LiseR18/KnockDoor/README.md

# Knocki
Knocki is a proof of concept that allows you to open a door by "knocking" a secret combination that you configured beforehand. 
**[Demo video](https://www.youtube.com/watch?v=I42KXvuVLV4)**

*Realised in the context of the Arduino project at Polytech Nice-Sophia*
