LiseR18/KnockDoor/Diapo Knocki.pdf

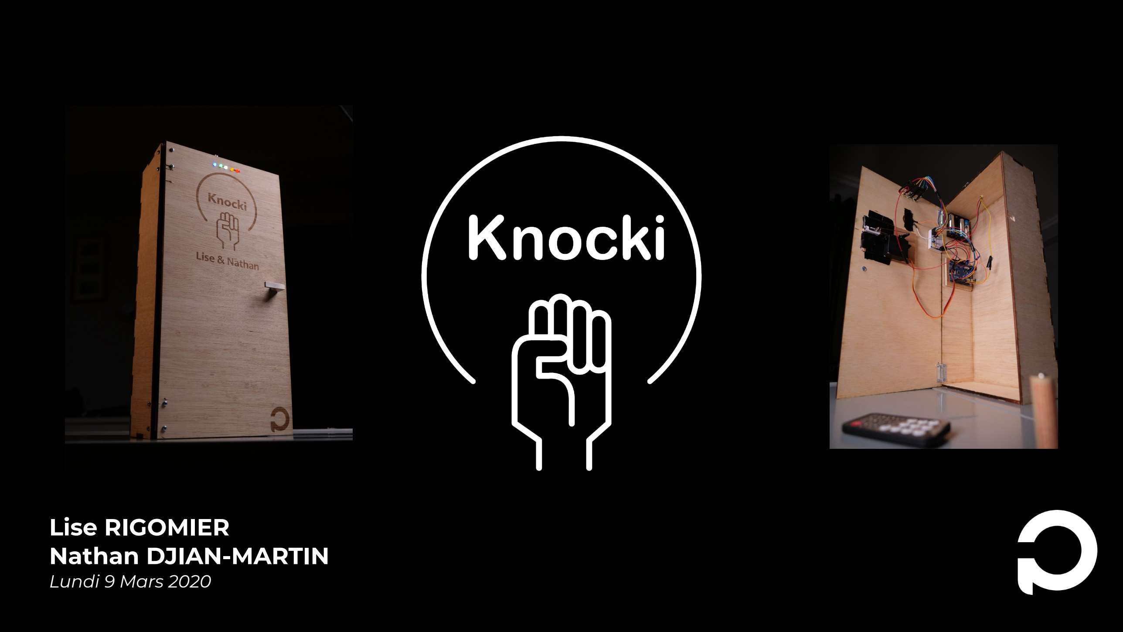
[picture p41: page 1]

Lise RIGOMIER
Nathan DJIAN-MARTIN
Lundi 9 Mars 2020

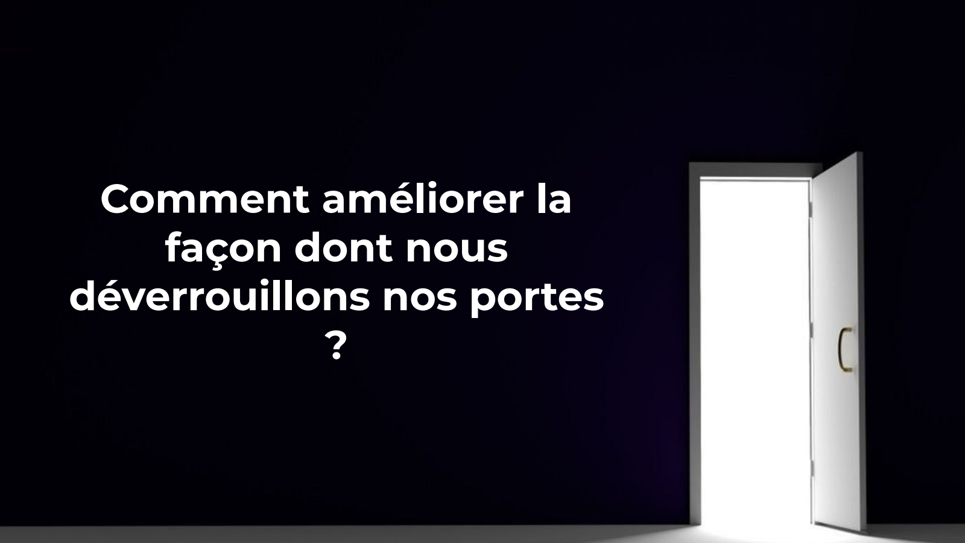
[picture p42: page 2]

Comment améliorer la
façon dont nous
déverrouillons nos portes
?

### SOMMAIRE

1 - Objectifs
2 - Présentation composants et code 3 - Démonstration
4 - Déroulement du projet
5 - Conclusion

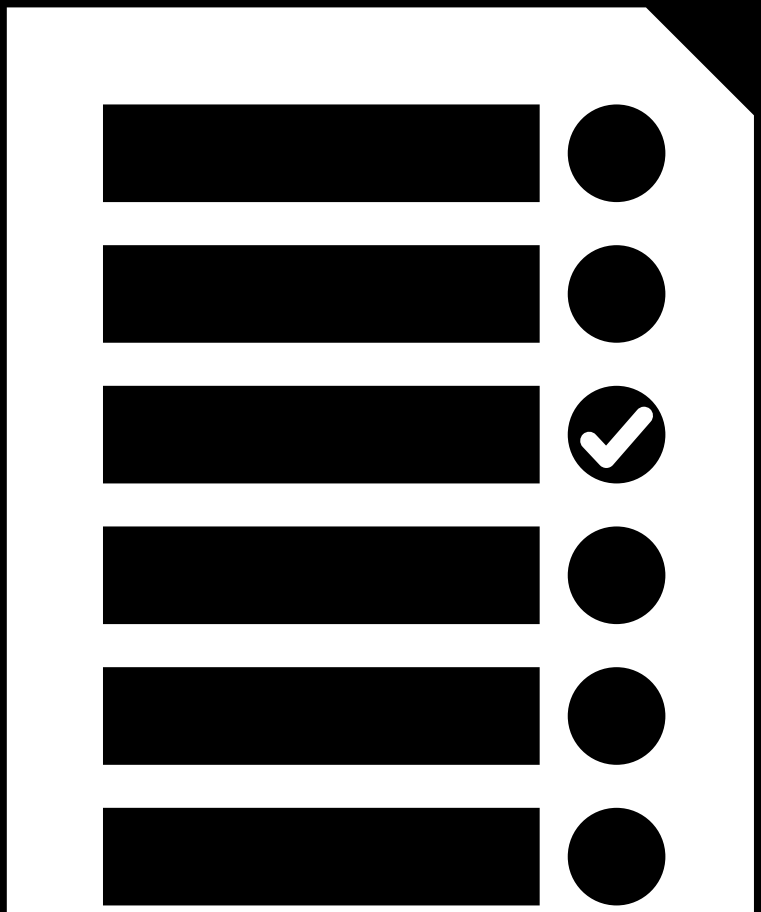
[picture p43: figure]

Détecter une combinaison
Comparer deux combinaisons Ouvrir/fermer la porte
Télécommande infrarouge
Communiquer avec l’utilisateur

### OBJECTIFS

DÉTECTER UNE COMBINAISON

Combinaison

+ écouterCombinaison

+ sauverCombinaison

+ récupCombinaison

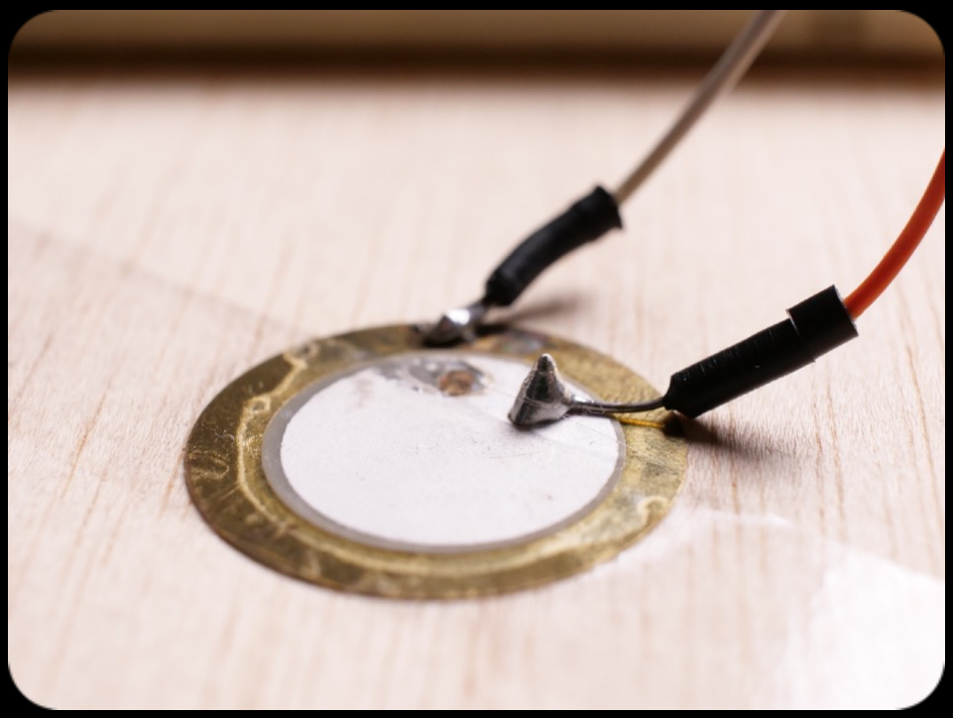
[picture p44: figure]

Coup 1 | Coup 2 Coup 3 | Coup 4

COMPARER DEUX COMBINAISONS

Combinaison

+ écouterCombinaison

+ sauverCombinaison

+ récupCombinaison

+ comparer

Combinaison de référence

Combinaison de l’utilisateur

OUVRIR/FERMER LA PORTE

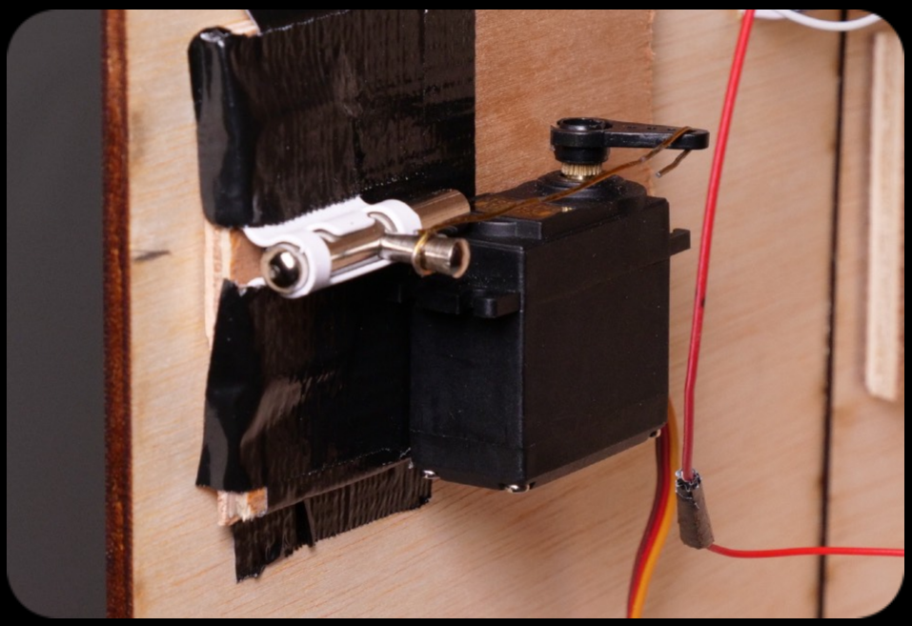
[picture p45: figure]

Servomoteur

+ ouvrirPorte

+ fermerPorte

Trombonne

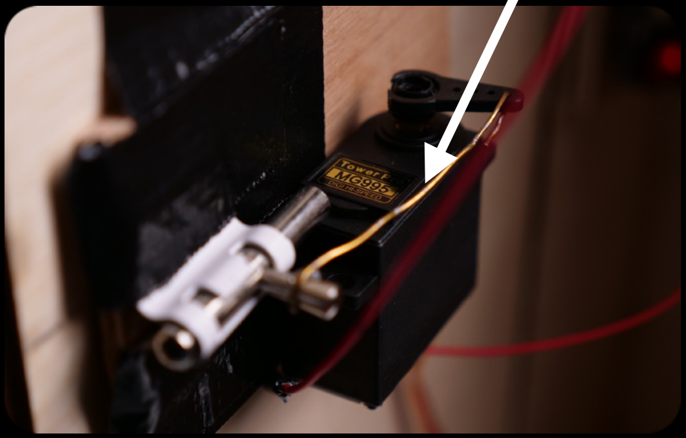
[picture p46: figure]

TÉLÉCOMMANDE

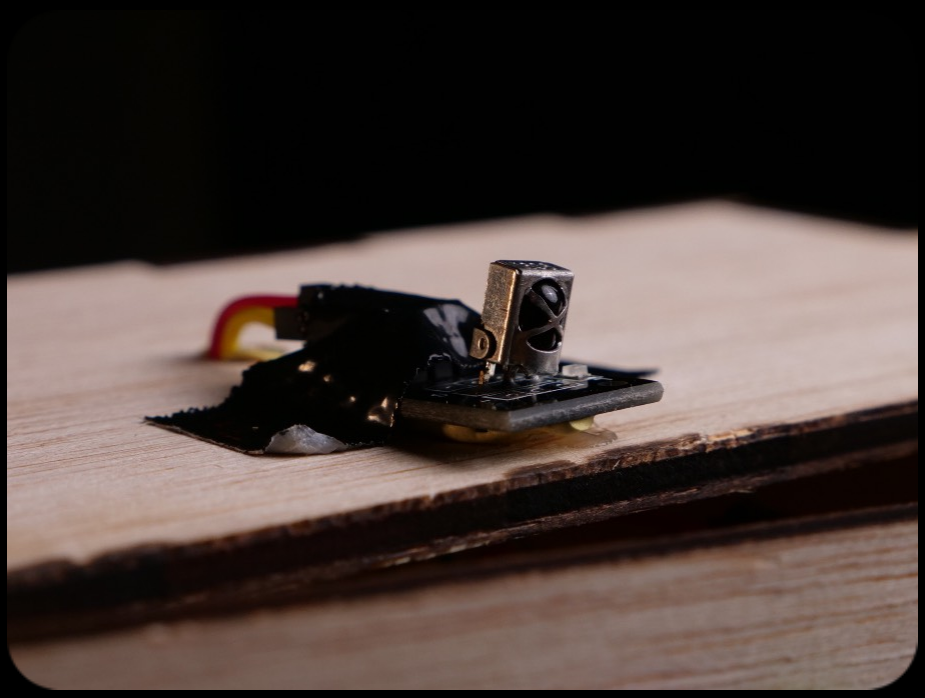
[picture p47: figure]
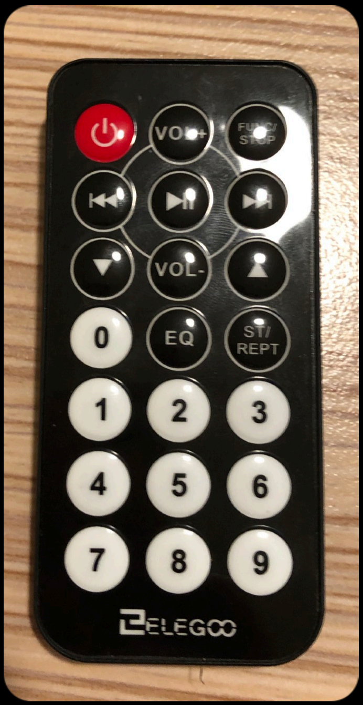
[picture p48: figure]

1

2

3

Ouvrir

Fermer

Nouvelle combinaison

Visualisation
combinaison

LEDS

Écoute en cours

Ouverture

Coup détecté

Enregistrement d’une
nouvelle combinaison
Fermeture/Mauvaise combinaison

LEDs

+ clignoter()

+ allumer()

+ éteindre()

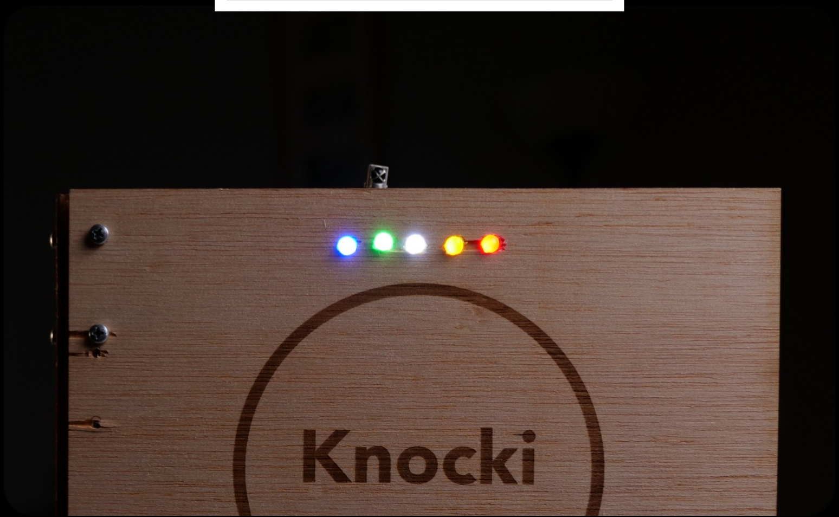
[picture p49: figure]

Servomoteur

+ ouvrirPorte()

+ fermerPorte()

Combinaison

+ écouterCombinaison()

+ sauverCombinaison()

+ récupCombinaison()

+ comparer()

LEDs

+ clignoter()

+ allumer()

+ éteindre()

KnockiCore

+ setup()

+ loop()

PROGRAMME

DÉMONSTRATION

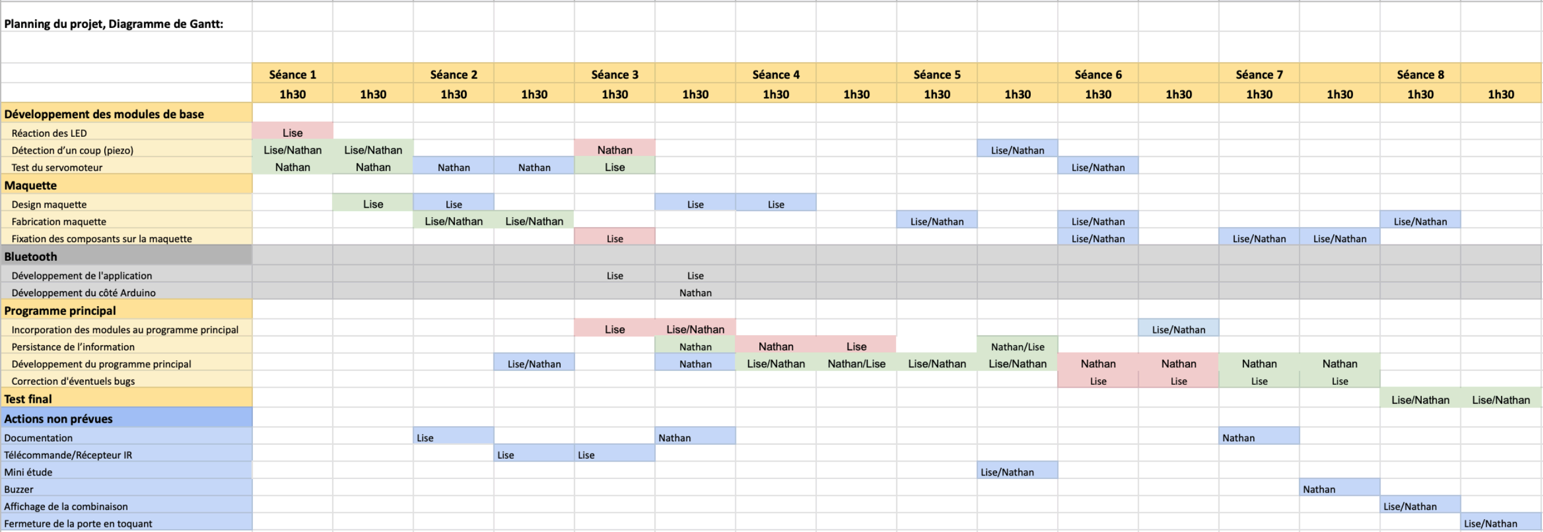
[picture p50: page 12]

DÉROULEMENT DU PROJET

Diagramme de Gantt

confiance

travail en équipe

autonomie

expérience

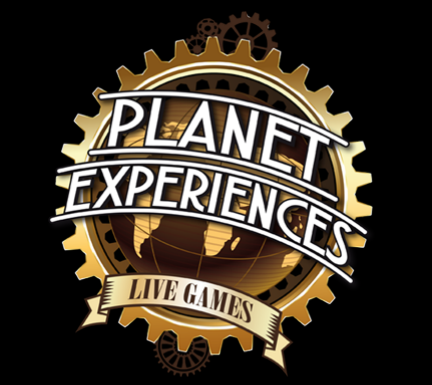
[picture p51: figure]

Planet Expériences,
Live Escape Games Antibes
