LiseR18/KnockDoor/Gantt Final.pdf

## Sheet1

## Projet Arduino : Knocki

### Planning du projet, Diagramme de Gantt:

| Séance 1 Séance 2 Séance 3 Séance 4 Séance 5 Séance 6 Séance 7 Séance 8 1h30 1h30 1h30 1h30 1h30 1h30 1h30 1h30 1h30 1h30 1h30 1h30 1h30 1h30 1h30 1h30

### Développement des modules de base

Réaction des LED Détection d’un coup (piezo) | Lise
Lise/Nathan Lise/Nathan | | Nathan | Lise/Nathan
Test du servomoteur | Nathan | Nathan | Nathan | Nathan | Lise | Lise/Nathan

### Maquette

Design maquette Fabrication maquette Fixation des composants sur la maquette | | Lise | Lise | | Lise Lise
| Lise/Nathan Lise/Nathan | | | Lise/Nathan | | Lise/Nathan | Lise/Nathan
| Lise | | Lise/Nathan | | Lise/Nathan Lise/Nathan

### Bluetooth

Développement de l'application | Lise | Lise
Développement du côté Arduino | | Nathan

### Programme principal

Persistance de l’information Développement du programme principal Correction d'éventuels bugs

Incorporation des modules au programme principal | Lise | Lise/Nathan | Lise/Nathan
| Nathan | Nathan Lise | | Nathan/Lise
| Lise/Nathan | | Nathan | Lise/Nathan Nathan/Lise Lise/Nathan Lise/Nathan | Nathan Nathan | Nathan Nathan
| | Lise Lise | Lise Lise
Test final | | Lise/Nathan Lise/Nathan

### Actions non prévues

Documentation Buzzer Affichage de la combinaison Fermeture de la porte en toquant | | Lise | | Nathan | | Nathan
Télécommande/Récepteur IR | Lise | Lise Mini étude | Lise/Nathan
| Nathan
Lise/Nathan
| Lise/Nathan
