LiseR18/KnockDoor/Diagramme de Gantt - Sheet1.pdf

## Sheet1

## Projet Arduino : Knocki

### Planning du projet, Diagramme de Gantt:

| Séance 1 Séance 2 Séance 3 Séance 4 Séance 5 Séance 6 Séance 7 Séance 8 1h30 1h30 1h30 1h30 1h30 1h30 1h30 1h30 1h30 1h30 1h30 1h30 1h30 1h30 1h30 1h30

### Développement des modules de base

Réaction des LED Détection d’un coup (piezo) Test du servomoteur | Lise Lise/Nathan Nathan | Nathan Maquette
Lise/Nathan Nathan | Nathan
Design maquette Fabrication maquette (sans les composants élec.) Fixation des composants sur la maquette | | Lise
| Lise/Nathan Lise/Nathan
| Lise

### Bluetooth

Développement de l'application Développement du côté Arduino | | Lise Lise
| | | Nathan

### Programme principal

Incorporation des modules au programme principal Persistance de l’information Développement du programme principal Correction d'éventuels bugs | | | | Lise Lise/Nathan
| Nathan Nathan Lise Nathan Lise
| Lise Nathan Lise Nathan Nathan Nathan Nathan Nathan
| | Lise Lise Lise Lise
Test final | | Lise/Nathan Lise/Nathan
