LiseR18/KnockDoor/Rapports séances/README.md

Répertoire dans lequel sont stockés les rapports de séance.
