LiseR18/KnockDoor/Médias/README.md

Répertoire contenant tous les médias de Knocki (photos, vidéos, logos...).
