LiseR18/KnockDoor/Rapports séances/Séance 6/README.md

Répertoire contenant les rapports de la séance du 10/02/2020
