LiseR18/KnockDoor/(commit log)

2019-12-10 Mise en ligne du rapport de Nathan
2019-12-10 Code test piezo + servo
    Mise en ligne des deux petits programmes utilisés pour tester le capteur piezo-électrique et le servomoteur (qui ne fonctionne pas pour l'instant)
2019-12-10 Mise en ligne compte rendu de Lise
2019-12-16 Ajout support du potentiomètre
    Le programme servo_test fonctionne désormais avec un potentiomètre. Il fait tourner le servomoteur de 0 à 180 degrés.
2020-01-06 Programme de test de la mémoire EEPROM
2020-01-06 Programme télécommande
    https://github.com/z3t0/Arduino-IRremote/releases/tag/v2.4.0
    il faut télécharger le fichier Remote
2020-01-06 Programme de test de détection de la combinaison
    Le programme se limite pour l'instant à la détection des coups (on utilise un bouton pour simplifier la procédure de test) et de la stocker dans un tableau. Cette version n'est pas encore fonctionnelle !
2020-02-03 Modif de debug
    Changement de place du code qui affiche dans la console à quel coup on est.
2020-02-03 Détection de coup avec piezo
    Programme de détection d'une combinaison avec le capteur piezo cette fois (contrairement à l'autre programme qui utilisait un bouton pour faciliter les phases de test).
2020-02-04 Rapport Nathan + tableau tentatives
    Mise en ligne du rapport de Nathan et du tableur de nos 10 tentatives de reproduction de combinaison.
2020-02-04 Comparaison combinaison + tableau EEPROM
    Mise en lignes du programme permettant de comparer deux combinaisons entre elles et du programme permettant de stocker un tableau d'entiers dans la mémoire EEPROM et de le lire.
2020-02-11 Fichiers KnockiCore
    Tous les fichiers nécessaires au fonctionnement du programme principal : KnockiCore
2020-02-18 MàJ KnockiCore
    Ajout du fichier Buzzer
    Fonctions LEDs terminées
    Fonctions Lock terminées
    Déclarations de la quasi-totalité des variables utiles
    Code de test dans le fichier principal afin de tester les composants et de permettre l'ouverture/fermeture du verrou avec le servomoteur grâce à la télécommande.
    [KnockiCore.ino, Led.ino, Lock.ino, Pattern.ino]
2020-03-02 Conflit avec la library servomoteur
2020-03-02 Verrouillage en toquant
    On peut maintenant verrouiller la porte sans la télécommande, simplement en donnant 2 coups espacés d'environ 300ms (modifiable dans le code)
2020-03-06 Mise en ligne diagramme de Gantt final
